tk20dk/wally/kicad/wally-pcb.png

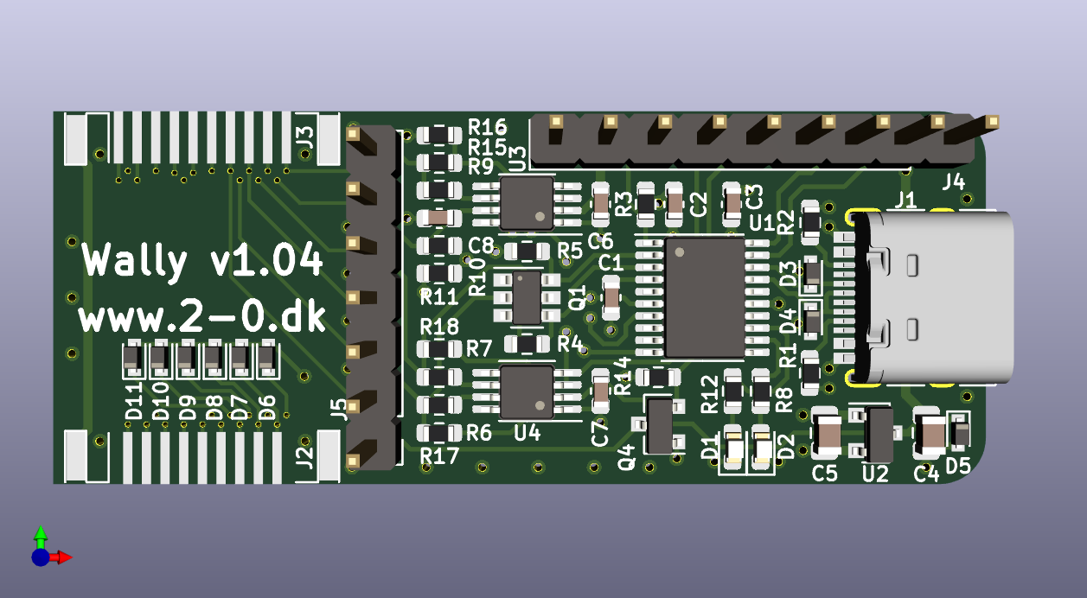
kicad/wally-pcb.png
