tk20dk/wally/README.md

# Wally - CEC sniffer, sink and source emulator
