tk20dk/wally/kicad/wally-sch.pdf

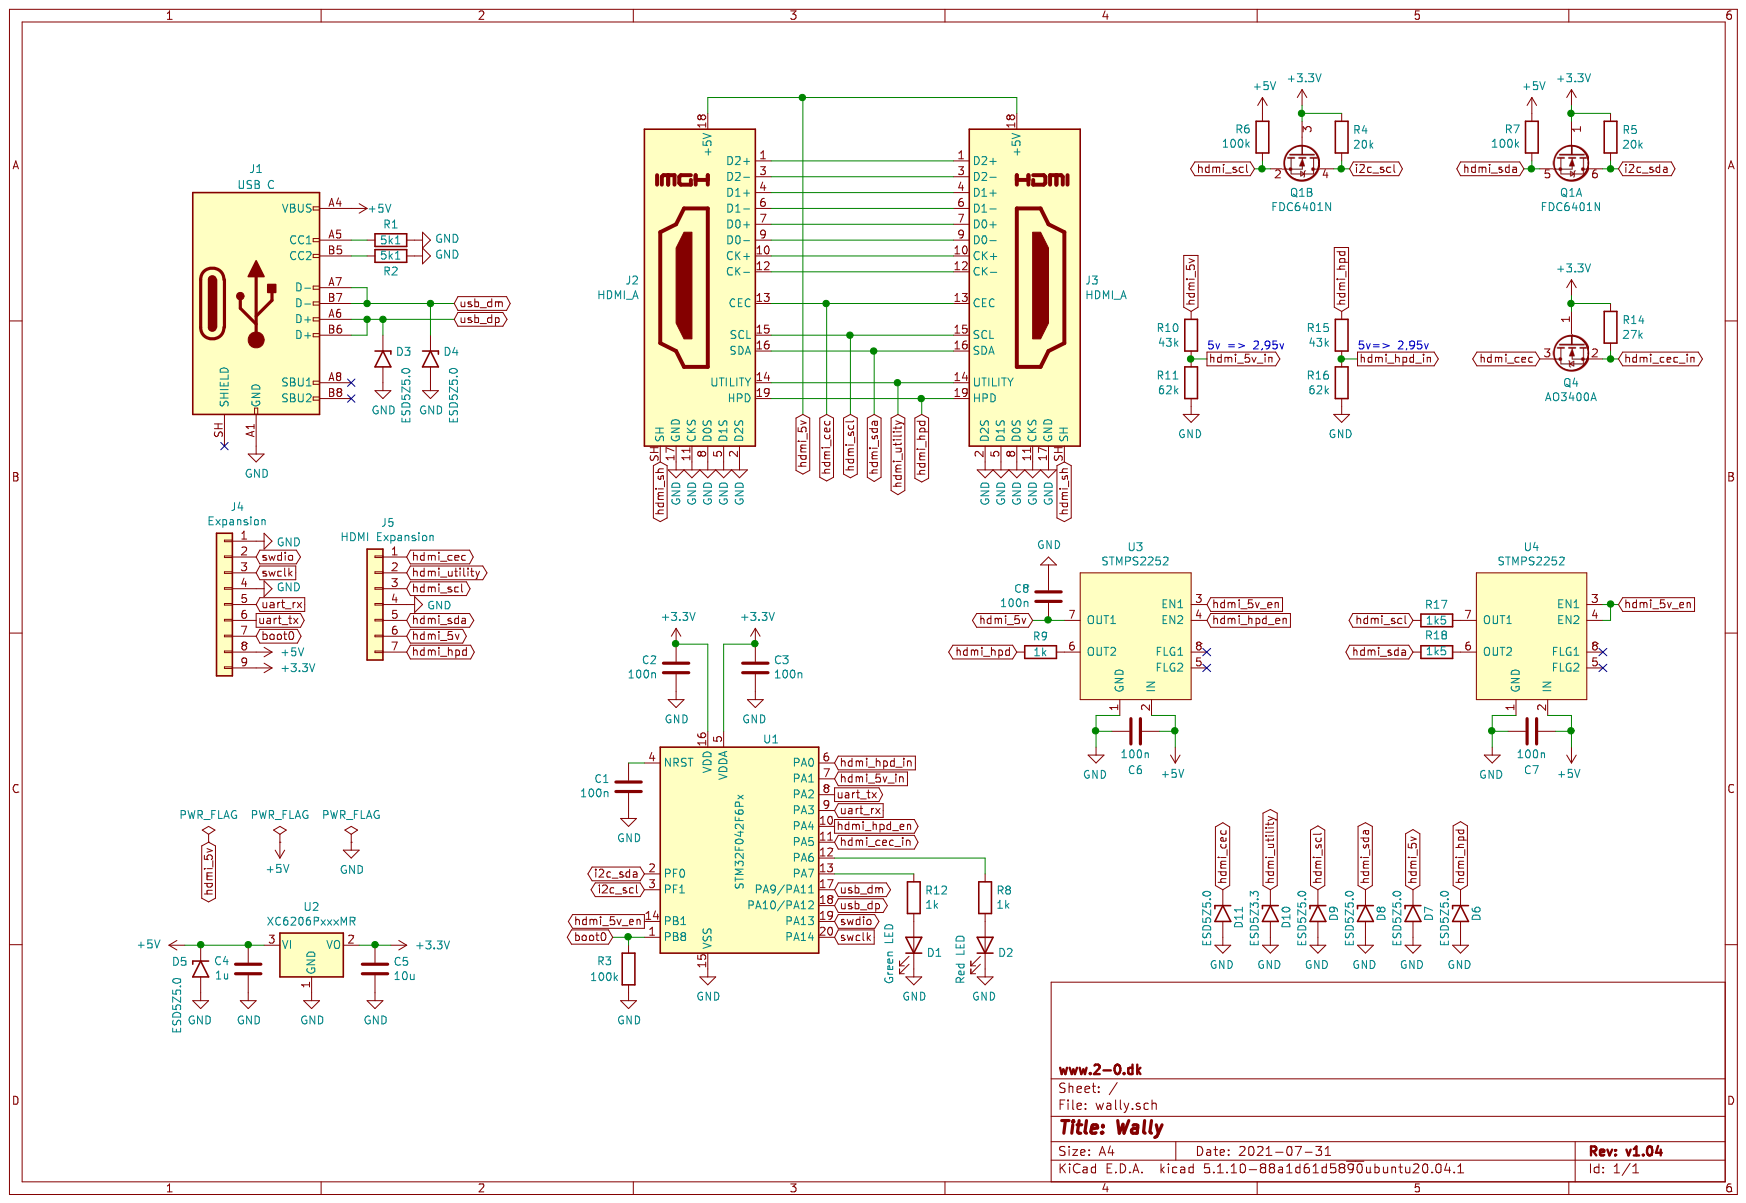
[picture p8: page 1]
