tk20dk/wally/kicad/wally.kicad_pcb

## KiCad design kicad/wally.kicad_pcb (2021-07-31)

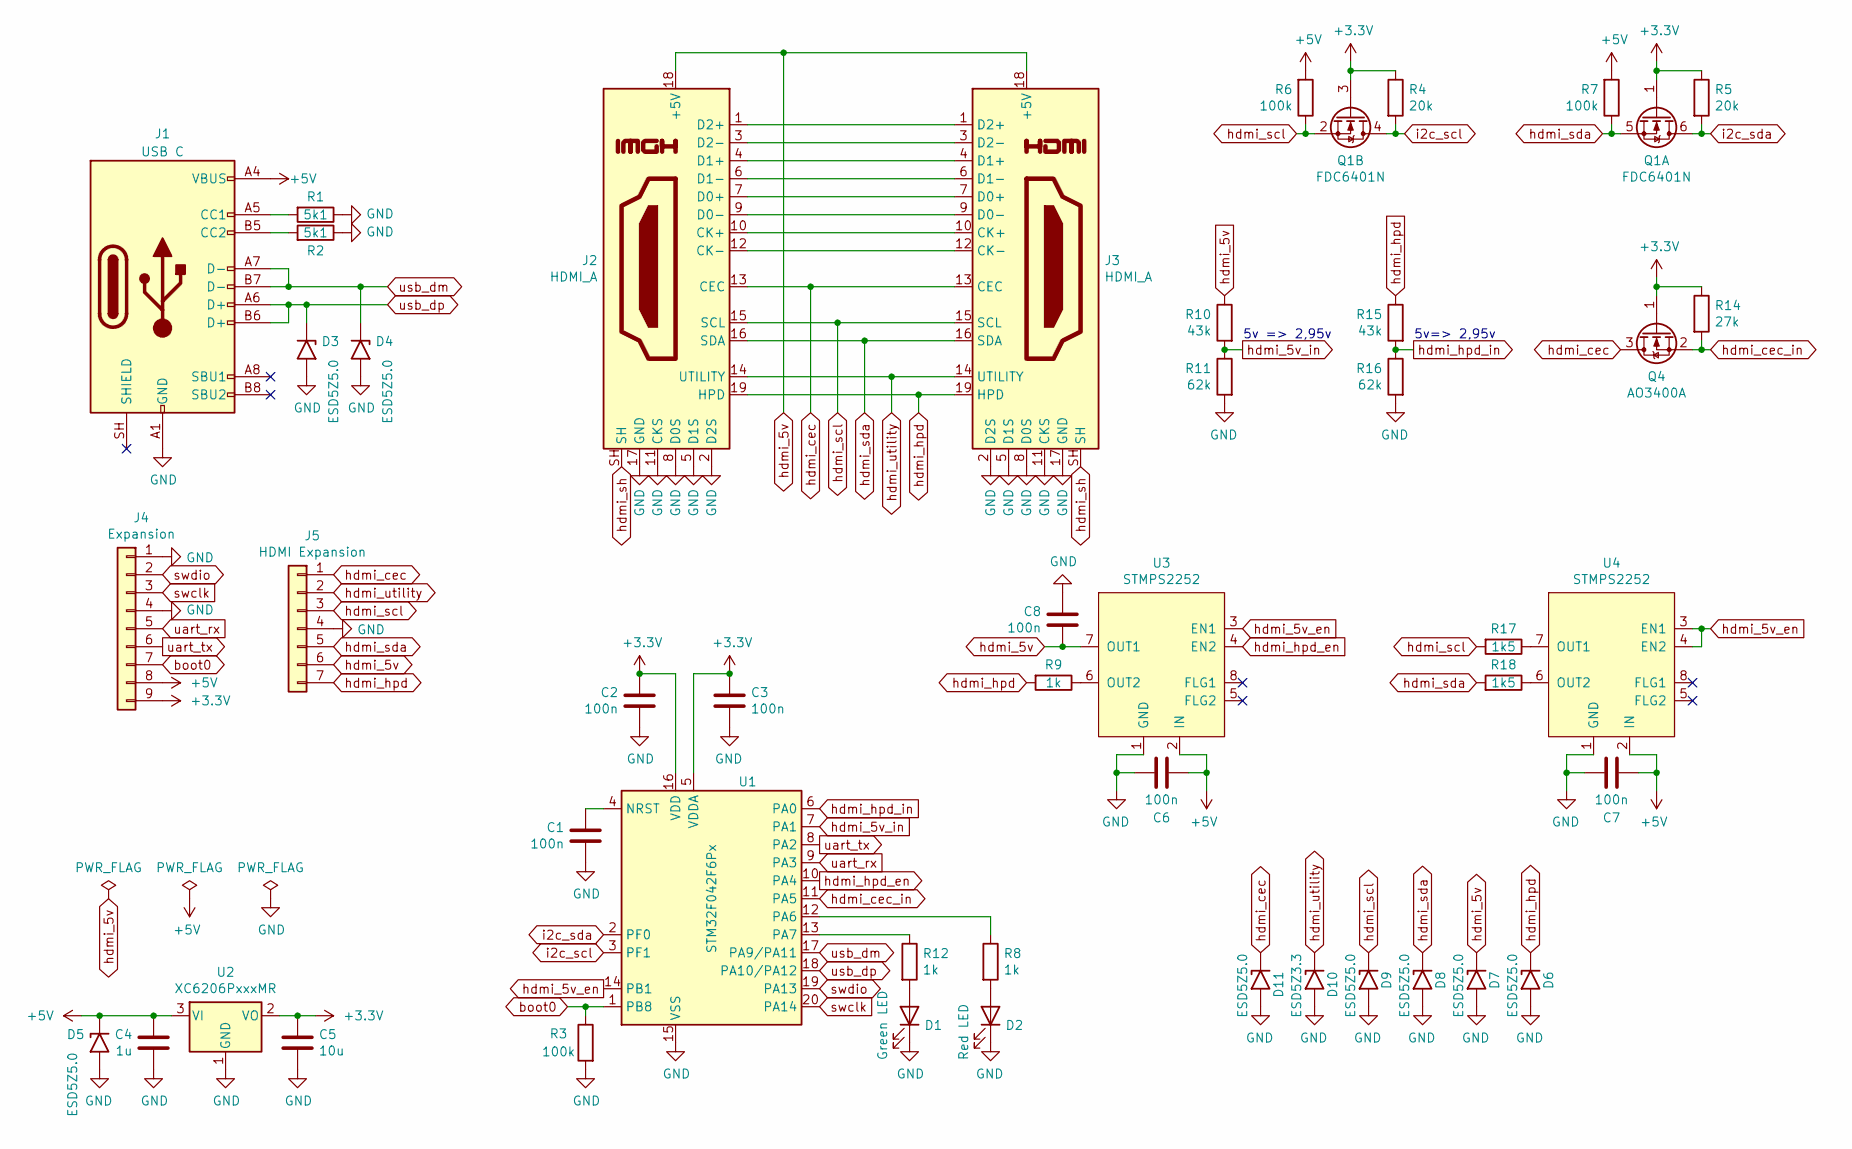
[picture p9: schematic wally.sch]

Parts:
C1, C2, C3, C6, C7, C8: 100n; C_0603_1608Metric
C4: 1u; C_0805_2012Metric
C5: 10u; C_0805_2012Metric
D1: Green LED; LED_0603_1608Metric
D2: Red LED; LED_0603_1608Metric
D3, D4, D5, D6, D7, D8, D9, D11: ESD5Z5.0; D_SOD-523
D10: ESD5Z3.3; D_SOD-523
J1: USB C; USB_C_Receptacle_HRO_TYPE-C-31-M-12
J2, J3: HDMI_A; HDMI_A_Male_Horizontal
J4: Expansion; PinHeader_1x09_P2.54mm_Vertical
J5: HDMI Expansion; PinHeader_1x07_P2.54mm_Vertical
Q1: FDC6401N; SuperSOT-6
Q4: AO3400A; SOT-23
R1, R2: 5k1; R_0603_1608Metric
R3, R6, R7: 100k; R_0603_1608Metric
R4, R5: 20k; R_0603_1608Metric
R8, R9, R12: 1k; R_0603_1608Metric
R10, R15: 43k; R_0603_1608Metric
R11, R16: 62k; R_0603_1608Metric
R14: 27k; R_0603_1608Metric
R17, R18: 1k5; R_0603_1608Metric
U1: STM32F042F6Px; TSSOP-20_4.4x6.5mm_P0.65mm
U2: XC6206PxxxMR; SOT-23
U3, U4: STMPS2252; MSOP-8_3x3mm_P0.65mm

Connections:
+3V3: C2.2, C3.2, C5.1, J4.9, Q1.1 (G), Q1.3 (G), Q4.1 (G), R4.1, R5.1, R14.1, U1.5 (VDDA), U1.16 (VDD), U2.2 (VO)
+5V: C4.2, C6.2, C7.2, D5.1 (A1), J1.A4 (VBUS), J1.A9 (VBUS), J1.B4 (VBUS), J1.B9 (VBUS), J4.8, R6.2, R7.2, U2.3 (VI), U3.2 (IN), U4.2 (IN)
GND: C1.1, C2.1, C3.1, C4.1, C5.2, C6.1, C7.1, C8.2, D1.1 (K), D2.1 (K), D3.2 (A2), D4.2 (A2), D5.2 (A2), D6.2 (A2), D7.2 (A2), D8.2 (A2), D9.2 (A2), D10.2 (A2), D11.2 (A2), J1.A1 (GND), J1.A12 (GND), J1.B1 (GND), J1.B12 (GND), J2.2 (D2S), J2.5 (D1S), J2.8 (D0S), J2.11 (CKS), J2.17 (GND), J3.2 (D2S), J3.5 (D1S), J3.8 (D0S), J3.11 (CKS), J3.17 (GND), J4.1, J4.4, J5.4, R1.1, R2.1, R3.2, R11.2, R16.2, U1.15 (VSS), U2.1 (GND), U3.1 (GND), U4.1 (GND)
unnamed: C1.2, U1.4 (NRST)
unnamed: D1.2 (A), R12.2
unnamed: D2.2 (A), R8.2
unnamed: J1.A5 (CC1), R1.2
unnamed: J1.B5 (CC2), R2.2
unnamed: J2.1 (D2+), J3.1 (D2+)
unnamed: J2.3 (D2-), J3.3 (D2-)
unnamed: J2.4 (D1+), J3.4 (D1+)
unnamed: J2.6 (D1-), J3.6 (D1-)
unnamed: J2.7 (D0+), J3.7 (D0+)
unnamed: J2.9 (D0-), J3.9 (D0-)
unnamed: J2.10 (CK+), J3.10 (CK+)
unnamed: J2.12 (CK-), J3.12 (CK-)
unnamed: R8.1, U1.12 (PA6)
unnamed: R9.1, U3.6 (OUT2)
unnamed: R12.1, U1.13 (PA7)
unnamed: R17.1, U4.7 (OUT1)
unnamed: R18.1, U4.6 (OUT2)
boot0: J4.7, R3.1, U1.1 (PB8)
hdmi_5v: C8.1, D7.1 (A1), J2.18 (+5V), J3.18 (+5V), J5.6, R10.1, U3.7 (OUT1)
hdmi_5v_en: U1.14 (PB1), U3.3 (EN1), U4.3 (EN1), U4.4 (EN2)
hdmi_5v_in: R10.2, R11.1, U1.7 (PA1)
hdmi_cec: D11.1 (A1), J2.13 (CEC), J3.13 (CEC), J5.1, Q4.3 (D)
hdmi_cec_in: Q4.2 (S), R14.2, U1.11 (PA5)
hdmi_hpd: D6.1 (A1), J2.19 (HPD), J3.19 (HPD), J5.7, R9.2, R15.1
hdmi_hpd_en: U1.10 (PA4), U3.4 (EN2)
hdmi_hpd_in: R15.2, R16.1, U1.6 (PA0)
hdmi_scl: D9.1 (A1), J2.15 (SCL), J3.15 (SCL), J5.3, Q1.2 (S), R6.1, R17.2
hdmi_sda: D8.1 (A1), J2.16 (SDA), J3.16 (SDA), J5.5, Q1.5 (S), R7.1, R18.2
hdmi_sh: J2.SH, J3.SH
hdmi_utility: D10.1 (A1), J2.14 (UTILITY), J3.14 (UTILITY), J5.2
i2c_scl: Q1.4 (D), R4.2, U1.3 (PF1)
i2c_sda: Q1.6 (D), R5.2, U1.2 (PF0)
swclk: J4.3, U1.20 (PA14)
swdio: J4.2, U1.19 (PA13)
uart_rx: J4.5, U1.9 (PA3)
uart_tx: J4.6, U1.8 (PA2)
usb_dm: D4.1 (A1), J1.A7 (D-), J1.B7 (D-), U1.17 (PA9/PA11)
usb_dp: D3.1 (A1), J1.A6 (D+), J1.B6 (D+), U1.18 (PA10/PA12)

Notes on the sheet:
5v => 2,95v
5v=> 2,95v

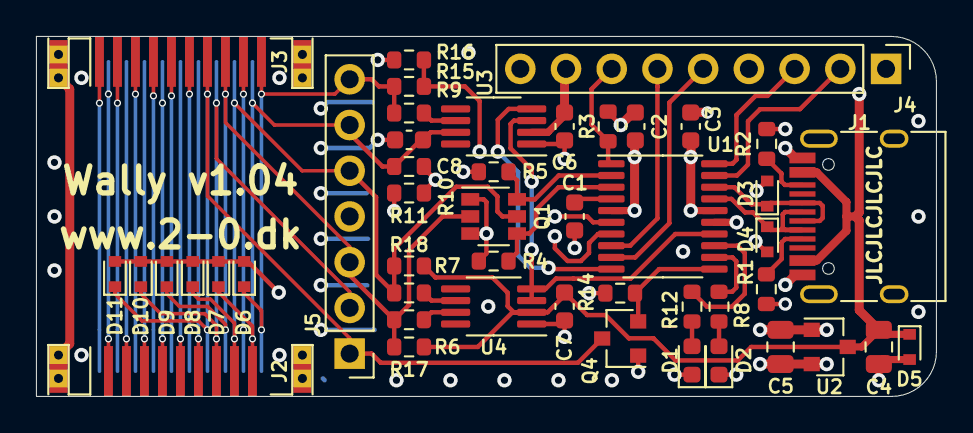
[picture p10: board wally.kicad_pcb from above]

Board: 4 copper layers, 50.0 x 20.0 mm, 47 parts (1 on the bottom side), 42 nets.
