tk20dk/wally/stm32/Core/Inc/main.h

#define HDMI_HPD_EN_Pin GPIO_PIN_8
#define HDMI_HPD_EN_GPIO_Port GPIOB
#define HDMI_SDA_Pin GPIO_PIN_0
#define HDMI_SDA_GPIO_Port GPIOF
#define HDMI_SCL_Pin GPIO_PIN_1
#define HDMI_SCL_GPIO_Port GPIOF
#define HDMI_5V_IN_Pin GPIO_PIN_0
#define HDMI_5V_IN_GPIO_Port GPIOA
#define HDMI_HPD_IN_Pin GPIO_PIN_1
#define HDMI_HPD_IN_GPIO_Port GPIOA
#define HDMI_5V_EN_Pin GPIO_PIN_4
#define HDMI_5V_EN_GPIO_Port GPIOA
#define HDMI_CEC_IN_Pin GPIO_PIN_5
#define HDMI_CEC_IN_GPIO_Port GPIOA
#define LED_RED_Pin GPIO_PIN_6
#define LED_RED_GPIO_Port GPIOA
#define LED_GREEN_Pin GPIO_PIN_7
#define LED_GREEN_GPIO_Port GPIOA
#define LED_YELLOW_Pin GPIO_PIN_1
#define LED_YELLOW_GPIO_Port GPIOB
