tk20dk/wally/(commit log)

2021-04-25 Wally v1.01
    [wally-B_Cu.gbr, wally-B_Mask.gbr, wally-B_Paste.gbr, wally-B_SilkS.gbr, wally-Edge_Cuts.gbr, wally-F_Cu.gbr, wally-F_Mask.gbr, wally-F_Paste.gbr]
2021-05-18 Wally v1.02
    [wally-B_Cu.gbr, wally-B_Mask.gbr, wally-B_Paste.gbr, wally-B_SilkS.gbr, wally-Edge_Cuts.gbr, wally-F_Cu.gbr, wally-F_Mask.gbr, wally-F_Paste.gbr]
2021-06-02 v1.02 board bring-up
    [wally.kicad_pcb, wally.sch]
2021-06-05 Wally v1.03
    [wally-B_Cu.gbr, wally-B_Mask.gbr, wally-B_Paste.gbr, wally-B_SilkS.gbr, wally-Edge_Cuts.gbr, wally-F_Cu.gbr, wally-F_Mask.gbr, wally-F_Paste.gbr]
2021-07-27 added serial usb driver
2021-07-27 removed serial usb driver
2021-07-31 Wally v1.04
    [wally-B_Cu.gbr, wally-B_Mask.gbr, wally-B_Paste.gbr, wally-B_SilkS.gbr, wally-Edge_Cuts.gbr, wally-F_Cu.gbr, wally-F_Mask.gbr, wally-F_Paste.gbr]
